zlsjtj/riscv-cim-accelerator/tools/requirements-ibex.txt

fusesoc==2.4.3
edalize==0.6.1
packaging==25.0
