zlsjtj/riscv-cim-accelerator/docs/assets/architecture.png

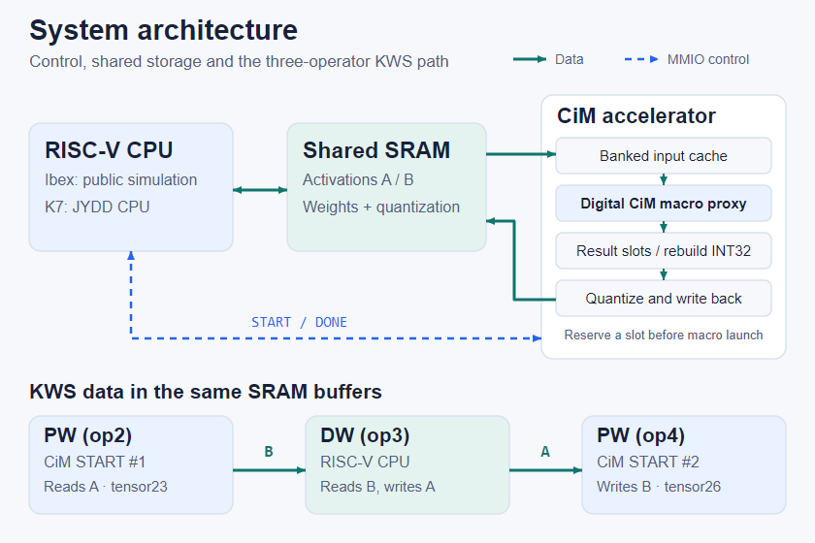
docs/assets/architecture.png
