zlsjtj/riscv-cim-accelerator/docs/assets/k7_subgraph_latency.png

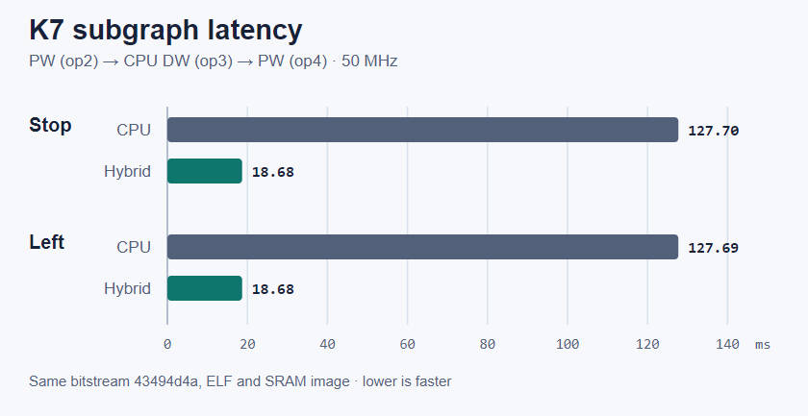
docs/assets/k7_subgraph_latency.png
