zlsjtj/riscv-cim-accelerator/docs/assets/social-preview.png

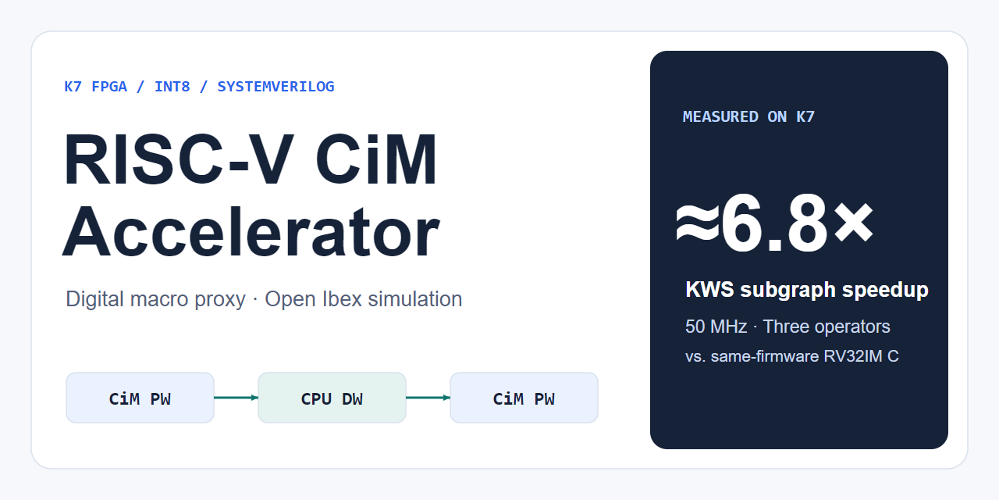
docs/assets/social-preview.png
