zlsjtj/riscv-cim-accelerator/docs/evidence/rtl_results.csv

case | M | mode | cycles | read_requests | write_requests | clock_edges
0 | 1 | 0 | 8382 | 1344 | 16 | 9566
0 | 1 | 1 | 8382 | 1344 | 16 | 17978
1 | 125 | 0 | 114290 | 17216 | 2000 | 132302
1 | 125 | 1 | 91820 | 17216 | 2000 | 224156
2 | 1 | 0 | 8382 | 1344 | 16 | 232572
2 | 1 | 1 | 8382 | 1344 | 16 | 240988
3 | 125 | 0 | 114290 | 17216 | 2000 | 355312
3 | 125 | 1 | 91820 | 17216 | 2000 | 447166
4 | 125 | 0 | 114290 | 17216 | 2000 | 561490
4 | 125 | 1 | 91820 | 17216 | 2000 | 653344
5 | 1 | 0 | 8382 | 1344 | 16 | 661760
5 | 1 | 1 | 8382 | 1344 | 16 | 670176
6 | 125 | 0 | 114290 | 17216 | 2000 | 784500
6 | 125 | 1 | 91820 | 17216 | 2000 | 876354
7 | 1 | 0 | 8382 | 1344 | 16 | 884770
7 | 1 | 1 | 8382 | 1344 | 16 | 893186
