zlsjtj/riscv-cim-accelerator/tools/k7.py

"""Build, simulate and run the V2.1 K7 prototype using local JYDD CPU sources."""
import argparse
import hashlib
import json
import os
import re
import shutil
import subprocess
import sys
import time
from concurrent.futures import ThreadPoolExecutor
from pathlib import Path
from threading import Event

import kws_fixture
from reference import ROOT, generate
from variants import DEFAULT_K7_VARIANT, VARIANTS

CPU = ("RF", "Control", "IMMGEN", "CCTL", "ALU", "ACTL", "CSR")
INCLUDES = ("defines", "myCPU_units", "myCPU_m_ext", "myCPU_bitmanip")
EXPECTED = [(0, 125), (0, 1), (1, 125), (1, 1)]


def run(command, log):
    command = [str(value) for value in command]
    print("RUN", subprocess.list2cmdline(command), flush=True)
    path = OUT / log
    with path.open("w", encoding="utf-8") as stream:
        result = subprocess.run(command, cwd=OUT, stdout=stream, stderr=subprocess.STDOUT)
    output = path.read_text(encoding="utf-8", errors="replace")
    print(output[-6000:], flush=True)
    if result.returncode:
        raise RuntimeError(f"{log} exited {result.returncode}")
    return output


def sha(path):
    return hashlib.sha256(path.read_bytes()).hexdigest()


def word_image(path, data):
    path.write_text("".join(f"{int.from_bytes(data[i:i+4], 'little'):08x}\n"
                            for i in range(0, len(data), 4)), encoding="ascii")


def cpu_files(source):
    return [source / "common" / f"{name}.sv" for name in CPU] + [
        source / "route_src/myCPU.sv", source / "route_src/uart.sv"]


def cpu_hashes(source):
    files = cpu_files(source) + [source / "common" / f"{name}.sv" for name in INCLUDES]
    missing = [p.relative_to(source).as_posix() for p in files if not p.is_file()]
    if missing:
        raise ValueError(f"Missing JYDD files under {source}: {', '.join(missing)}")
    return {p.relative_to(source).as_posix(): sha(p) for p in files}


def prepared_hashes():
    return {name: sha(OUT / name) for name in ("firmware.mem", "sram.mem",
                                               "cpu_include/myCPU_m_ext.sv")}


def check_prepared(source, two_layer, retain, prefetch, early_write, fixture, diagnostic):
    metadata = OUT / "build_metadata.json"
    if not metadata.is_file():
        raise ValueError("Run k7.py prepare with the same --out and --cpu-source first")
    record = json.loads(metadata.read_text(encoding="utf-8"))
    if (record.get("cpu_sources") != cpu_hashes(source) or record.get("prepared_files") != prepared_hashes()
            or record.get("two_layer", False) != two_layer or record.get("retain", False) != retain
            or record.get("prefetch", False) != prefetch
            or record.get("early_write", False) != early_write
            or record.get("diagnostic", False) != diagnostic
            or record.get("kws_fixture_sha256") != (kws_fixture.load_fixture(fixture)[1]["fixture_sha256"] if fixture else None)):
        raise ValueError("CPU sources or generated files differ from prepare. Run k7.py prepare again")


def stage_m_unit(source):
    original = source / "common/myCPU_m_ext.sv"
    data = original.read_bytes()
    old = b"always_ff @(posedge clk or posedge rst)"
    new = b"always_ff @(posedge clk)"
    if data.count(old) != 1:
        raise ValueError(f"Unexpected M-unit reset structure in {original}")
    patched = OUT / "cpu_include/myCPU_m_ext.sv"
    patched.parent.mkdir(exist_ok=True)
    patched.write_bytes(data.replace(old, new, 1))
    return {"source": str(original), "original_sha256": sha(original),
            "staged_sha256": sha(patched), "change": "M-unit reset is sampled on clk"}


def prepare(source, tools, two_layer, retain, prefetch, early_write, fixture, diagnostic):
    sources = cpu_hashes(source)
    fixture_metadata = {}
    if fixture:
        image, manifest = kws_fixture.load_fixture(fixture)
        ram = bytearray(image)
        fixture_metadata = dict(kws_fixture_sha256=manifest["fixture_sha256"], diagnostic=diagnostic)
    else:
        cases = generate("real")
        case = next((case for case in cases if case["M"] == 125 and "activation_sha256" in case), None)
        if case is None:
            raise ValueError("A verified real tensor23 export is required. Run tools/run.py --real-activations.")
        idx = case["index"]
        memory = bytes.fromhex((ROOT / f"build/vectors/mem{idx}.hex").read_text())
        golden = bytes.fromhex((ROOT / f"build/vectors/gold{idx}.hex").read_text())
        activation = memory[0x1000:0x1000+8000]
        if len(golden) != 8000 or hashlib.sha256(activation).hexdigest() != case["activation_sha256"]:
            raise ValueError("Board input fixture disagrees with verified tensor23")
        ram = bytearray(65536)
        fixture_metadata = dict(fixture_case=idx, activation_sha256=case["activation_sha256"],
                                golden_sha256=hashlib.sha256(golden).hexdigest())
    m_unit = stage_m_unit(source)
    cc = tools / "riscv-none-elf-gcc.exe"
    copy = tools / "riscv-none-elf-objcopy.exe"
    run([cc, "--version"], "gcc_version.log")
    defines = ["-DCIM_TWO_LAYER"] if two_layer else []
    if retain:
        defines.append("-DCIM_RETAIN_BENCHMARK")
    if prefetch:
        defines.append("-DCIM_PREFETCH_BENCHMARK")
    if early_write:
        defines.append("-DCIM_EARLY_WRITE_BENCHMARK")
    linker, main_source = "k7_boot.ld", "k7_main.c"
    if fixture:
        linker, main_source = "kws_k7.ld", "kws_main.c"
        defines = ["-DKWS_K7", "-fstack-usage"]
        if diagnostic:
            defines.append("-DKWS_DIAGNOSTIC")
    run([cc, "-march=rv32im", "-mabi=ilp32", "-Os", "-ffreestanding", *defines,
         "-fno-builtin", "-msmall-data-limit=0", "-mno-relax",
         "-ffunction-sections", "-fdata-sections", "-nostdlib",
         "-Wl,--gc-sections,--no-relax,-Map=firmware.map",
         "-T", ROOT / "sw" / linker, ROOT / "sw/k7_boot.S", ROOT / "sw" / main_source,
         ROOT / "sw/cim.c", ROOT / "sw/cim_sw.c", "-lgcc", "-o", "firmware.elf"], "firmware_build.log")
    for section in ("text", "data"):
        run([copy, "-O", "binary", "-j", "." + section, "firmware.elf", section + ".bin"],
            "firmware_" + section + ".log")
    text = (OUT / "text.bin").read_bytes()
    data = (OUT / "data.bin").read_bytes()
    ram[:len(data)] = data
    if two_layer:
        from chain_fixture import populate
        chain = populate(ram, idx)
    elif not fixture:
        ram[0xa000:0xa000+8000] = activation
        ram[0xc000:0xd000] = memory[0x4000:0x5000]
        ram[0xd000:0xd300] = memory[0x6000:0x6300]
        ram[0xd400:0xd400+8000] = golden
    word_image(OUT / "sram.mem", ram)
    word_image(OUT / "firmware.mem", text.ljust(16384, b"\x00"))
    metadata = {
        "cpu_source_root": str(source), "cpu_sources": sources,
        "prepared_files": prepared_hashes(),
        "firmware_elf_sha256": sha(OUT / "firmware.elf"), "text_bytes": len(text),
        **fixture_metadata,
        "two_layer": two_layer,
        "retain": retain,
        "prefetch": prefetch,
        "early_write": early_write,
        "m_unit_reset_patch": m_unit,
        "fpga_part": "xc7k325tffg900-2", "ref_clock_hz": 200000000, "core_clock_hz": 50000000,
    }
    if two_layer:
        metadata["chain"] = chain
    (OUT / "build_metadata.json").write_text(json.dumps(metadata, indent=2), encoding="utf-8")


def parse_results(output):
    rows = []
    for line in output.splitlines():
        match = re.fullmatch(r"(?:# )?CIM_RESULT ((?:[0-9a-f]{8} ){5}[0-9a-f]{8})", line.strip())
        if match:
            mode, m, cycles, count, bad, writes = (int(field, 16) for field in match[1].split())
            if not cycles or count != 64*m or bad != 0 or writes != count//4:
                raise ValueError(f"Invalid result: {line}")
            rows.append(dict(mode=mode, M=m, cycles=cycles, outputs=count,
                             mismatches=bad, committed_words=writes))
    if "CIM_PASS" not in output.split() or [(row["mode"], row["M"]) for row in rows] != EXPECTED:
        raise RuntimeError("Incomplete accelerator result sequence")
    return rows


def parse_chain_results(output, methods):
    rows = []
    for line in output.splitlines():
        match = re.fullmatch(r"(?:# )?CHAIN_RESULT ((?:[0-9a-f]{8} ){6}[0-9a-f]{8})", line.strip())
        if match:
            method, m, cycles, count, mid_bad, out_bad, status = (int(field, 16) for field in match[1].split())
            if not cycles or count != 64*m or mid_bad or out_bad or status:
                raise ValueError(f"Invalid result: {line}")
            rows.append(dict(method=method, M=m, cycles=cycles, bytes_per_layer=count,
                             intermediate_mismatches=mid_bad, final_mismatches=out_bad))
    expected = [(method, m) for m in (1, 125) for method in range(methods)]
    if "CIM_PASS" not in output.split() or [(row["method"], row["M"]) for row in rows] != expected:
        raise RuntimeError("Incomplete two-layer result sequence")
    return rows


def parse_cpu_results(output):
    rows = []
    for line in output.splitlines():
        match = re.fullmatch(r"(?:# )?CPU_RESULT ((?:[0-9a-f]{8} ){3}[0-9a-f]{8})", line.strip())
        if match:
            m, cycles, count, bad = (int(field, 16) for field in match[1].split())
            if not cycles or count != 64*m or bad:
                raise ValueError(f"Invalid software result: {line}")
            rows.append(dict(M=m, cycles=cycles, outputs=count, mismatches=bad))
    if [row["M"] for row in rows] != [1, 125]:
        raise RuntimeError("Incomplete RV32IM software baseline")
    return rows


def parse_resets(output):
    rows = []
    for line in output.splitlines():
        match = re.fullmatch(r"(?:# )?CIM_RESET ((?:[0-9a-f]{8} ){8}[0-9a-f]{8})", line.strip())
        if match:
            mode, pre, pending, before, post, cycles, after, retained, invalid = (
                int(field, 16) for field in match[1].split()
            )
            if (pre != 1 or pending != 1 or not 0 < before < 2000 or
                    (post, cycles, after, invalid) != (0, 0, 0, 0) or retained != before):
                raise ValueError(f"Invalid reset record: {line}")
            rows.append(dict(mode=mode, status_before=pre, read_response_at_reset=pending,
                             committed_before=before, status_after=post, cycles_after=cycles,
                             committed_after=after, retained_words=retained, invalid_words=invalid))
    if [row["mode"] for row in rows] != [0, 1]:
        raise RuntimeError("Expected an in-flight warm reset in each mode")
    return rows


def simulate(source, questa, trace_blocks, profile_tasks, turn, cache, two_layer, fixture, diagnostic):
    if fixture:
        (OUT / "soc_kws_results.json").unlink(missing_ok=True)
    if not (OUT / "work").exists():
        run([questa / "vlib.exe", "work"], "vlib.log")
    sources = cpu_files(source) + sorted((ROOT / "rtl").glob("*.sv")) + [
        ROOT / "fpga/cim_rv_system.sv", ROOT / "tb/tb_rv_system.sv"]
    run([questa / "vlog.exe", "-sv", f"+incdir+{OUT / 'cpu_include'}+{source / 'common'}",
         *sources], "soc_compile.log")
    generics = [f"-gTURNAROUND={turn}", f"-gINPUT_CACHE={cache}"]
    control_test = "+TEST_CHAIN_CONTROL" if two_layer else "+TEST_START_COUNTER"
    control_pass = "PASS chain control" if two_layer else "PASS accepted START"
    retain_args = ["+TEST_RETAIN"] if cache >= 3 else []
    if cache >= 4:
        retain_args.append("+TEST_PREFETCH")
    if cache == 5:
        retain_args.append("+TEST_EARLY_WRITE")
    if fixture:
        retain_args.append("+TEST_KWS")
    counter = run([questa / "vsim.exe", "-c", "-voptargs=-suppress 7061", *generics, "tb_rv_system",
                   control_test, *retain_args, "-do",
                   "onbreak {quit -code 1}; onerror {quit -code 1}; run -all; quit -code 0"],
                  "start_counter.log")
    if control_pass not in counter:
        raise RuntimeError("SoC directed control test did not pass")
    # Existing RF and predictor arrays have power-up initializers as well as
    # always_ff writes. Keep the source intact and allow that Questa diagnostic.
    trace_args = ["+TRACE_BLOCKS"] if trace_blocks else []
    if profile_tasks:
        trace_args.append("+PROFILE_TASKS")
    if two_layer:
        trace_args.append("+TEST_CHAIN")
    output = run([questa / "vsim.exe", "-c", "-voptargs=-suppress 7061", *generics, "tb_rv_system", *trace_args, *retain_args, "-do",
                  "onbreak {quit -code 1}; onerror {quit -code 1}; run -all; quit -code 0"],
                 "soc_simulation.log")
    if fixture:
        result = kws_fixture.parse_results(output, fixture, diagnostic, OUT / "soc_tensors")
        (OUT / "soc_kws_results.json").write_text(json.dumps(result, indent=2), encoding="utf-8")
        return
    if two_layer:
        (OUT / "soc_chain_results.json").write_text(json.dumps(parse_chain_results(output, cache + 1), indent=2), encoding="utf-8")
        return
    (OUT / "soc_results.json").write_text(json.dumps(parse_results(output), indent=2), encoding="utf-8")
    (OUT / "soc_reset_results.json").write_text(json.dumps(parse_resets(output), indent=2), encoding="utf-8")
    (OUT / "soc_cpu_results.json").write_text(json.dumps(parse_cpu_results(output), indent=2), encoding="utf-8")


def capture_uart(uart, transcript, stop, seconds):
    deadline = time.monotonic() + seconds
    while not stop.is_set() and time.monotonic() < deadline:
        transcript += uart.read(512)
        if b"CIM_PASS\n" in transcript or b"CIM_FAIL\n" in transcript:
            return


def program(vivado, target, port, archive, variant, usr_access, two_layer, fixture, diagnostic):
    import serial

    bit = archive if archive else OUT / "cim_k7.bit"
    if not bit.is_file() or not target or not port:
        raise ValueError("Program requires a routed bitstream, explicit JTAG serial and COM port")
    log = (bit.parent / "impl_vivado.log").read_text(encoding="utf-8", errors="replace")
    if "K7_BITSTREAM_READY" not in log.splitlines():
        raise ValueError("Last implementation did not pass the bitstream gate")
    metadata = bit.parent / "bitstream_metadata.json"
    if archive and not metadata.is_file():
        metadata = bit.parent / "board_results.json"
    record = json.loads(metadata.read_text(encoding="utf-8"))
    if (record.get("bit_sha256"), record.get("usr_access")) != (sha(bit), usr_access):
        raise ValueError("Bitstream SHA-256 or USR_ACCESS disagrees with the selected configuration")
    if not archive and record.get("prepared_files") != prepared_hashes():
        raise ValueError("Prepared images changed since implementation. Run impl again")
    if fixture and (record.get("kws_fixture_sha256") != kws_fixture.load_fixture(fixture)[1]["fixture_sha256"]
                    or record.get("diagnostic") != diagnostic):
        raise ValueError("Bitstream disagrees with the KWS fixture or diagnostic configuration")
    if fixture:
        (OUT / "board_results.json").unlink(missing_ok=True)
    transcript = bytearray()
    with serial.Serial(port, 115200, timeout=0.25) as uart:
        uart.reset_input_buffer()
        stop = Event()
        with ThreadPoolExecutor(max_workers=1) as pool:
            capture = pool.submit(capture_uart, uart, transcript, stop, 120)
            try:
                run([vivado, "-mode", "batch", "-nojournal", "-log", "program_vivado.log",
                     "-source", ROOT / "fpga/program_k7.tcl", "-tclargs", target, bit, usr_access], "program.log")
                capture.result(timeout=75 if diagnostic else 20)
            except TimeoutError:
                pass  # Save the partial transcript before reporting missing results.
            finally:
                stop.set()
    (OUT / "board_uart.log").write_bytes(transcript)
    output = transcript.decode("ascii", errors="replace")
    print("\n".join(line for line in output.splitlines() if not line.startswith("KWS_TENSOR ")))
    result = {"jtag_serial": target, "uart_port": port, "uart_baud": 115200,
              "variant": variant, "bit_sha256": sha(bit), "usr_access": usr_access}
    if fixture:
        result.update(kws_fixture.parse_results(output, fixture, diagnostic, OUT / "board_tensors"),
                      diagnostic=diagnostic)
        result["kws_fixture_sha256"] = result["fixture_sha256"]
    elif two_layer:
        result["chain"] = parse_chain_results(output, VARIANTS[variant][1] + 1)
    else:
        result.update(resets=parse_resets(output), tasks=parse_results(output), software=parse_cpu_results(output))
    (OUT / "board_results.json").write_text(json.dumps(result, indent=2), encoding="utf-8")


def main():
    global OUT
    sys.stdout.reconfigure(errors="backslashreplace")
    parser = argparse.ArgumentParser(description=__doc__)
    parser.add_argument("step", choices=("prepare", "sim", "impl", "program"))
    parser.add_argument("--cpu-source", type=Path, help="JYDD source directory with common/ and route_src/")
    parser.add_argument("--gcc-bin", type=Path, help="xPack RV32 GCC bin directory, or put GCC on PATH")
    parser.add_argument("--variant", choices=VARIANTS, default=DEFAULT_K7_VARIANT,
                        help=f"hardware configuration (default: {DEFAULT_K7_VARIANT})")
    parser.add_argument("--out", type=Path, help="Build and capture directory")
    parser.add_argument("--two-layer", action="store_true", help="run the banked two-layer benchmark firmware")
    parser.add_argument("--kws", type=Path, metavar="FIXTURE", help="run the real KWS fixture instead of the historical benchmark")
    parser.add_argument("--diagnostic", action="store_true", help="append a separate KWS tensor capture run")
    parser.add_argument("--bitstream", type=Path, help="For program, a matching bit beside impl_vivado.log")
    parser.add_argument("--trace-blocks", action="store_true", help="For sim, write task-relative block_trace.csv")
    parser.add_argument("--profile-tasks", action="store_true", help="For sim, write task-relative task_edges.csv")
    parser.add_argument("--jtag")
    parser.add_argument("--port")
    args = parser.parse_args()
    fixture = args.kws.resolve() if args.kws else None
    if args.diagnostic and not fixture:
        parser.error("--diagnostic requires --kws")
    if fixture and (args.two_layer or args.variant != "banked"):
        parser.error("--kws uses the banked single-task hardware for each PW")
    early_write = args.variant == "banked-early-write"
    prefetch = args.variant == "banked-prefetch" or early_write
    retain = args.variant == "banked-retain" or prefetch
    if args.two_layer and not (args.variant == "banked" or retain):
        parser.error("--two-layer requires a banked variant")
    if retain and not args.two_layer:
        parser.error(f"{args.variant} requires --two-layer")
    if args.bitstream and args.step != "program":
        parser.error("--bitstream requires program")
    if args.trace_blocks and args.step != "sim":
        parser.error("--trace-blocks requires sim")
    if args.profile_tasks and args.step != "sim":
        parser.error("--profile-tasks requires sim")
    if args.step != "program" and args.cpu_source is None:
        parser.error(f"{args.step} requires --cpu-source pointing to authorized local JYDD sources")
    if args.step == "prepare" and args.gcc_bin is None:
        gcc = shutil.which("riscv-none-elf-gcc.exe")
        if not gcc:
            parser.error("prepare requires --gcc-bin or riscv-none-elf-gcc.exe on PATH")
        args.gcc_bin = Path(gcc).parent
    turn, cache, usr_access = VARIANTS[args.variant]
    default_out = ("k7_interlayer_cache" if retain else "k7_two_layer") if args.two_layer else f"k7_matrix_{args.variant}"
    if early_write:
        default_out = "k7_interlayer_writeback"
    elif prefetch:
        default_out = "k7_interlayer_schedule"
    if args.two_layer and not retain:
        usr_access = "43494d45"
    if fixture:
        default_out = "k7_kws_diag" if args.diagnostic else "k7_kws"
        usr_access = "43494d4a" if args.diagnostic else "43494d49"
    OUT = (args.out or ROOT / "build" / default_out).resolve()
    source = args.cpu_source.resolve() if args.cpu_source else None
    vivado = Path(os.environ.get("VIVADO_BIN", "E:/Xilinx/Vivado/2023.2/bin")) / "vivado.bat"
    questa = Path(os.environ.get("QUESTA_BIN", "E:/questasim64_2024.1/win64"))
    OUT.mkdir(parents=True, exist_ok=True)
    if args.step in ("sim", "impl"):
        check_prepared(source, args.two_layer, retain, prefetch, early_write, fixture, args.diagnostic)
    if args.step == "prepare":
        prepare(source, args.gcc_bin.resolve(), args.two_layer, retain, prefetch, early_write, fixture, args.diagnostic)
    elif args.step == "sim":
        simulate(source, questa, args.trace_blocks, args.profile_tasks, turn, cache, args.two_layer, fixture, args.diagnostic)
    elif args.step == "impl":
        output = run([vivado, "-mode", "batch", "-nojournal", "-log", "impl_vivado.log",
                      "-source", ROOT / "fpga/build_k7.tcl", "-tclargs", source, turn, cache, usr_access],
                     "implementation.log")
        if "K7_BITSTREAM_READY" not in output.splitlines():
            raise RuntimeError("Implementation did not pass the bitstream gate")
        record = {"bit_sha256": sha(OUT / "cim_k7.bit"), "usr_access": usr_access,
                  "variant": args.variant, "turnaround": turn, "input_cache": cache,
                  "prepared_files": prepared_hashes(), "two_layer": args.two_layer}
        if fixture:
            record.update(kws_fixture_sha256=kws_fixture.load_fixture(fixture)[1]["fixture_sha256"],
                          diagnostic=args.diagnostic)
        (OUT / "bitstream_metadata.json").write_text(json.dumps(record, indent=2), encoding="utf-8")
    else:
        program(vivado, args.jtag, args.port, args.bitstream.resolve() if args.bitstream else None,
                args.variant, usr_access, args.two_layer, fixture, args.diagnostic)


if __name__ == "__main__":
    main()
