zlsjtj/riscv-cim-accelerator/(commit log)

2026-11-05 Publish the verified 50 MHz CiM accelerator v0.1.0
    [rtl_results.csv]
2026-11-05 Add fixed-response SRAM waveform baseline alongside variable waits
    [k7.py, run.py, tb_accel.sv]
2026-11-05 Record the four-way 50 MHz comparison and select the combined K7 default
    [fixed.csv, real.csv, traffic.csv]
2026-11-06 Profile input stalls and bank scratchpad replay without expanding capacity
    [cim_accel.sv, cim_k7_top.sv, cim_rv_system.sv, compare_arch.py, k7.py, profile_replay.py, tb_accel.sv, tb_rv_system.sv]
2026-11-06 Record same-board replay comparison and select banked K7 default
    [fixed.csv, profile.csv, real.csv, traffic.csv]
2026-11-06 Archive two-layer K7 timing and independent golden checks
    [comparison.csv, soc_timeline_summary.csv, traffic.csv]
2026-11-06 Record K7 interlayer retention timing and SRAM traffic
    [comparison.csv, old_baseline_tile0.csv, same_bitstream_tile0.csv, traffic.csv]
2026-11-06 Prefetch the next row into a consumed second-layer input slot
2026-11-06 Record second-layer replay schedule timing and K7 evidence
    [archived_tile0.csv, comparison.csv, same_bitstream_tile0.csv, tile0_early_edges.csv, traffic.csv]
2026-11-06 Record second-layer writeback traces and K7 comparison
    [backend_counts.csv, comparison.csv, tile0_classified_edges.csv, tile0_summary.csv, traffic.csv]
2026-11-06 Record real KWS reference, Ibex and 50 MHz board evidence
